motivated3/ESP32-AirSense/doc/enclosure/README.md

# AirDock 60 结构

当前公开方案是 [AirDock 60 分舱底座](airdock-60/README.md)：屏幕与水平面成 60°，水平传感器舱、开放走线、可拆托盘。

公开目录只保留当前模型、工程和生成链所需的 helper / 冻结接口输入。旧 R 编号目录是相对路径依赖，不表示附带整套旧后盖；不必从旧版本开始打印。
