motivated3/ESP32-AirSense/doc/HA端接入与保存说明.md

# HA 端接入与保存说明

方案说明：采用 **1 分钟汇总、正常每分钟上传一次、分钟记录长期保留**，在现有 HA 内看历史。无需 CSV 导出，不用小时／日汇总代替短途行车曲线。

完整契约、配置、位置响应和测试入口见 [HA 集成说明](../homeassistant/README.md)。

## 采集、汇总、上传分别处理

- 固件保持原采集：SCD41 的 CO₂／温湿度约 5 秒新值，SFA40 甲醛约每秒读取。
- 每一分钟累积实际新且有效的样本，保存平均、最高、最低和有效样本数。正常一分钟约 12 组 CO₂／温湿度、60 组甲醛；预热或失败时不足正常，不补零、不凑数。
- 正常每 60 秒上传一条；40 分钟车程约 40 条，长途连续记录。断网后可按原时间补传，唯一键去重，不重复入库。
- 车辆停车断电断网时没有测量。可控关机可尝试补发不足一分钟尾段；突然断电时 RAM 中未上传数据可能丢失。
- AIR V1 固件已实现分钟汇总、独立 HTTPS 上传、失败重试和断网 RAM 补传；按自己的 HA 部署后，仍需检查真实设备上传。

## 复用现有 HTTPS

- 上传：`POST https://ha.example.com:8123/api/air_monitor/ingest`
- 看板：`https://ha.example.com:8123/air-monitor/overview`

上面的地址为占位示例，需替换为自己的 HA HTTPS 地址。自定义集成注册 HA 自身 HTTP 服务，复用现有 HA 的域名、TLS 和端口，不开新公网端口。每设备专属密钥用于自己的记录上传；成功响应还包含 HA 家庭位置，供自动主题使用，不向固件提供 HA 管理令牌。摘要位于 `/config/air_monitor_devices.yaml`，设备端原始密钥放在 Git 忽略的 `.air-ha/credentials.json` 用于本板构建；具体配置见[板型 README](../main/boards/custom/waveshare-air-monitor-1.8-v1/README.md#ha-分钟上报配置)。

## 分钟历史独立长期保存

每条 v2 记录含实际采样开始／结束时间、接收时间、设备 ID、启动会话、序号、开机经过时间及四项分钟统计。SQLite `/config/.storage/air_monitor.sqlite3` 的 `minute_records` 独立表不自动清理；只长期保存分钟汇总，不保存每秒原始值。

HA 原生小时长期统计不能改成一分钟；直接修改 Recorder 历史内部表也不可取。因此用 HA 内的分钟曲线卡片读取独立分钟表，沿用 HA 登录，不增加另一套网站或 App。旧补传以原采样时间出现在该分钟曲线，不逐条重放成当前读数。

当前实体显示最近一段的分钟平均，附最高／最低／样本数。只接受新鲜且更新的当前值，超 120 秒再于 15 秒刷新内变为不可用；通信超时显示离线。停车不永久维持最后读数，不填零；曲线保留缺失标记，空档断线。

未校时两个绝对时间明确为 null，只保留 uptime_ms；记录不能在绝对时间曲线上定位，不能伪造日期。错误／预热／无有效样本的指标用 null。

## 不改变其他 HA 数据

本集成不修改已有 Recorder 的数据库连接、保留天数或过滤配置，也不要求外部 MySQL。Recorder 的清理策略**不影响独立保存的一分钟记录**；部署环境中的设备、自动化及其他数据库策略保持不变。

分钟库需备份及管理磁盘，不能把“不自动清理”当成无需备份。新部署应单独确认备份与恢复，不使用个人开发环境的检查结果作为默认保证。

## HA 内查看

侧栏“空气检测”包含在线状态、最近一分钟平均、四项分钟曲线及最高／最低范围。可选最近一趟、近 7 天／30 天和自选历史时间；单次查询最多 31 天，但保存不设 31 天期限。

“最近一趟”按超过 5 分钟无数据分段、最多显示 24 小时；它不是汽车点火检测。停车和已知无效段断线；短途 40 分钟仍保留约 40 个点。看板不使用按日汇总作主视图。

接口检查字段、单位、数值、时间、批次和大小；事务提交后才 ACK，内容冲突整批回滚；设备收到 accepted 后才释放对应 RAM。细节见协议说明。

参考：[HA Recorder](https://www.home-assistant.io/integrations/recorder/)、[长期统计](https://www.home-assistant.io/docs/configuration/long-term-statistics/)。
