motivated3/ESP32-AirSense/doc/浓度读数颜色分级.md

# 浓度读数颜色分级

保留 368×448 布局，按浓度改变主页及历史页“当前”数字的颜色。温湿度来源保持 SCD41；浓度提醒采用主页状态和可选短提示音，不显示全屏告警弹窗。

## 分级

| 指标 | 原色 | 黄色 | 红色 |
| --- | --- | --- | --- |
| CO₂ / ppm | <1000 | 1000–1999 | ≥2000 |
| 甲醛 / ppb | <65 | 65–79 | ≥80 |

原色沿用原界面的深绿／米白。甲醛以界面显示的四舍五入整数 ppb 分档，使数字和颜色边界一致。浅色背景使用较深的琥珀黄、红色，深绿卡片和夜间采用较亮的同类颜色，保证大数字可读。

颜色是即时浓度提示，独立于用户设置的提醒阈值与连续 30 秒触发规则。关闭提醒或调高提醒值不改变数字分级；持续偏高的状态也不能把高浓度红字覆盖成黄字。当前提醒不显示弹窗，见[行为说明](自动主题与提醒.md)。

## 依据与边界

- 德国环境署 UBA 用 1000 和 2000 ppm 划分 CO₂ 通风提示等级，原文红色范围为 >2000 ppm。本产品把 2000 整值计入红色，属于稍保守的显示边界选择。[UBA 说明](https://www.umweltbundesamt.de/richtig-lueften-in-schulen)、[原始指南](https://www.umweltbundesamt.de/sites/default/files/medien/pdfs/kohlendioxid_2008.pdf)。
- HSE 指出持续高于 1500 ppm 应改善通风，CO₂ 只用于通风参考。因此本次不改变已有默认 1500 ppm 持续 30 秒告警；2000 ppm 不代表急性中毒分界。[HSE 指南](https://www.hse.gov.uk/ventilation/using-co2-monitors.htm)。
- GB/T 18883—2022 的甲醛限值为 0.08 mg/m³、1 小时平均；GB/T 27630—2011 车内指南为 0.10 mg/m³，并有规定的车辆静止、门窗关闭等检测条件。[室内标准](https://www.ndcpa.gov.cn/doc/ucap/1625444428300685312/document/20230607/ZgwODgwF.pdf)、[车内指南](https://sthjt.hubei.gov.cn/hjsj/hbbz/dqhjbhbz/qhjbz/qhjgb/201111/P020111115588026202206.pdf)。
- 以 25°C、101.325 kPa、甲醛摩尔质量约 30.026 g/mol 作理想气体换算，0.08 mg/m³ 约 65.2 ppb，0.10 mg/m³ 约 81.5 ppb。产品使用 65 / 80 ppb 作为方便阅读、稍保守取整的提醒线，不把 0.08 mg/m³ 错当作 80 ppb。

甲醛颜色属于本产品选择的提醒等级，不是标准规定的颜色。实时变色不等于完成标准要求的平均时间、采样和检测流程，不能由此宣称达标或绝对安全。

## 数据状态

无值、未连接、预热、过期、读取错误或额定环境条件不合格时，显示中性色。甲醛负值、非有限值及超出 0–2000 ppb 的无效值不参与分级，显示“—”，不会误变成低浓度原色。CO₂ 高于 5000 ppm 时保留超量程说明，并继续显示红色。

不增加颜色渐变动画或后台刷新任务，复用现有的样本刷新和相同样式去重。不另设大字模式。
