motivated3/ESP32-AirSense/doc/自动主题与提醒.md

# 自动主题与浓度提醒

## 自动主题

设置可选择“日间”“夜间”“自动”。自动模式按太阳位置计算日夜，沿用分别保存的日夜亮度；已有配置不会被强制改成自动。

位置取自自己的 Home Assistant 家庭经纬度，通过已鉴权的分钟上传 ACK 中 `solar_location` 返回。固件校验后缓存到 NVS；UTC 由上传端的 HTTPS Date 建立，不另请求手机定位或第三方定位服务。

**设备上传密钥也能取得 HA 家庭坐标**，因此只应发给可信设备并按私有凭据保存；它不能读取分钟历史或获取 HA 管理权限。旧 HA 集成不返回坐标时固件保持兼容，但首次自动主题需要更新集成、配置位置并完成校时。

同次开机暂时断网后，已缓存位置和已同步的时钟可继续计算。重启后需要重新取得有效 UTC；缺位置或时间时保持当前主题，仍可手动切换。车载设备使用的是 HA 家庭位置，不是车辆实时位置，跨地区行驶时日夜切换可能与当地日出日落不同。

## 浓度提醒

持续偏高通过主页状态与读数颜色表达，保留阈值、各指标和短提示音开关。**不显示全屏告警弹窗，不抢占对话，也不为了告警唤醒屏幕。** 每轮提示音最多一次，遵守音量、静音、音频忙碌及关机保护；忙碌时跳过，不在之后补响。

无效或过期数据不能当作零浓度。颜色阈值的来源、单位和适用范围见[颜色分级](浓度读数颜色分级.md)。
