motivated3/ESP32-AirSense/doc/验证记录.md

# 公开源码快照验证

日期：2026-11-02。本记录只描述本轮源码、无私有 HA 配置的构建和主机验证，不代表新一轮实机刷写或车内测量验收。

| 项目 | 结果 |
| --- | --- |
| ESP-IDF | 固定 `9a97f6c54ec638111ce55cd36581b3c192f15207`，v6.1.0，ESP32-S3 |
| 板型 | `waveshare-air-monitor-1.8-v1`，中文，16 MB Flash / 8 MB PSRAM |
| 专用构建入口 | `bash scripts/build_air_monitor.sh` 完整构建通过 |
| HA 配置 | 构建目录未放 `.air-ha/credentials.json`；生成头为 `kEnabled=false`，地址和密钥均为空 |
| 核心原生测试 | 13 / 13 通过 |
| 含 LVGL 界面的原生测试 | 15 / 15 通过，含主界面和对话页 |
| Python 主机测试 | 运行 296 项，295 项通过、1 项跳过；跳过项为缺少本机 cJSON / mbedTLS 开发头文件的 MCP 测试类 |
| HA 后端 | 29 / 29 通过，真实 SQLite 和回环 HTTP |
| HA 卡片 | 5 / 5 Node 测试通过 |
| AirDock | 导出实体、接口、模块包络、硬件及采样拆卸路径检查通过；3MF 网格、姿态、冻结输入哈希守卫通过 |
| 公开文件检查 | 不含私有配置、旧 Git 历史、设备部署记录、历史 ZIP 和原 `doc/hardware/` 厂商下载；保留的 3MF 内部成员也检查了个人路径及凭据模式 |

主机环境使用 macOS Command Line Tools，C/C++23 编译器明确选择 macOS SDK；为本机直接编译测试临时指定了 SDK 包装器，没有修改项目代码来跳过检查。最初的缺环境依赖/沙盒父进程查询失败在重跑前处理，未计为通过。

当前 README 的三张 PNG 来自本轮原生测试输出，尺寸为 368×448，读数和日期都是测试数据。

## 构建产物校验

以下仅标识本轮本机生成的文件，二进制不纳入 Git，也没有随源码首发上传。

| 文件 | 字节数 | SHA-256 |
| --- | --- | --- |
| `build/xiaozhi.bin` | 3419136 | `43ff2ffad09c14504184b60bfd1621cb82efcbc875eb4a4c0205ed6730be30d8` |
| `build/merged-binary.bin` | 10004645 | `b1b4923cfda5bf4be98e9055c6406f183273e21b99bfc892895ee35c5c65dab5` |
| `build/generated_assets.bin` | 1616037 | `5c4e6eae3478cd58ebfd3596accfca3a8dab1569234a1d08464421f71053f288` |

不同源码、工具环境或构建元数据可能生成不同字节，不能用本表校验之后重新编译的任意固件。刷写地址仍以同次构建的 `flash_args` / `flasher_args.json` 为准。

## 未覆盖的实物验收

本轮没有刷写设备、上传真实浓度到 HA 或启动 3D 打印。传感器真实性与校准、原壳配合、USB 关机电源轨、装壳温升、日晒和车内并发仍需在实际硬件上检查；测试通过不能据此承诺准确室温、固定帧率或阳光下可读性。
