motivated3/ESP32-AirSense/doc/enclosure/airdock-60/AirDock60_roof_vents.png

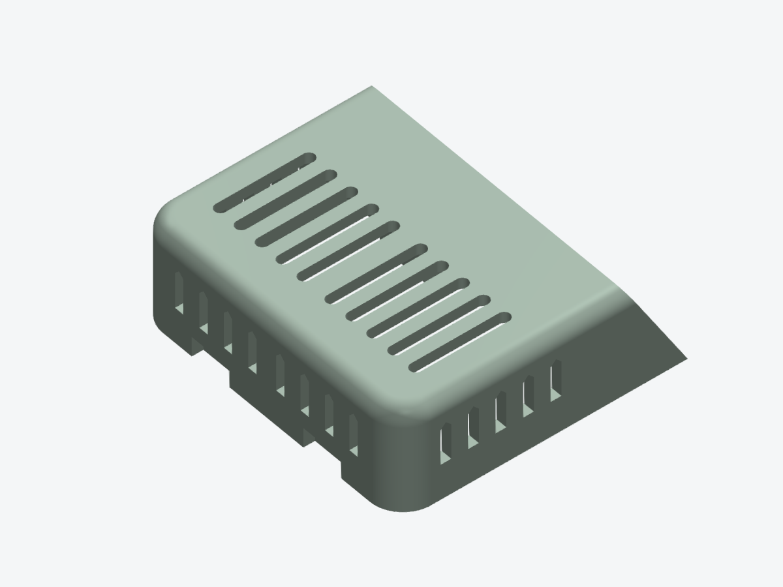
doc/enclosure/airdock-60/AirDock60_roof_vents.png
