motivated3/ESP32-AirSense/doc/enclosure/airdock-60/AirDock60_TRAY.step

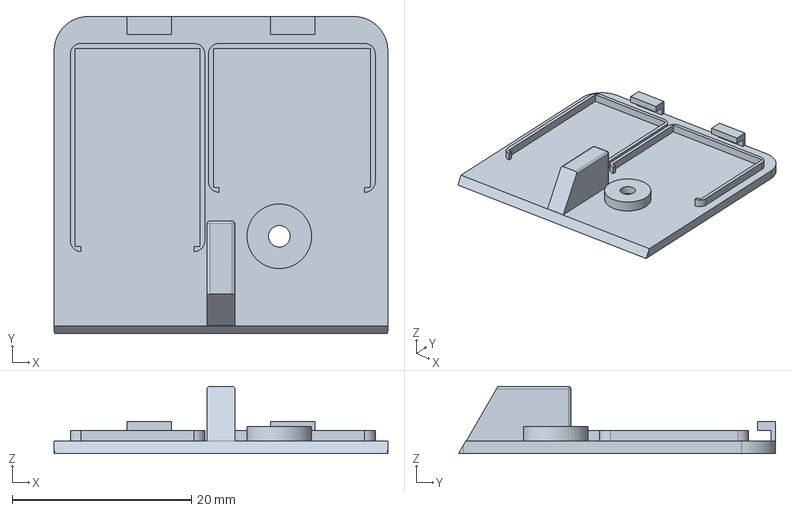
[picture p9: CAD file, 2026-11-02]
doc/enclosure/airdock-60/AirDock60_TRAY.step
37.2 x 35.3 x 7.50 mm
