motivated3/ESP32-AirSense/doc/enclosure/r12-continuous-round/support-interface/R12_PETG_LOCAL_SUPPORT_INTERFACE_BambuStudio.3mf

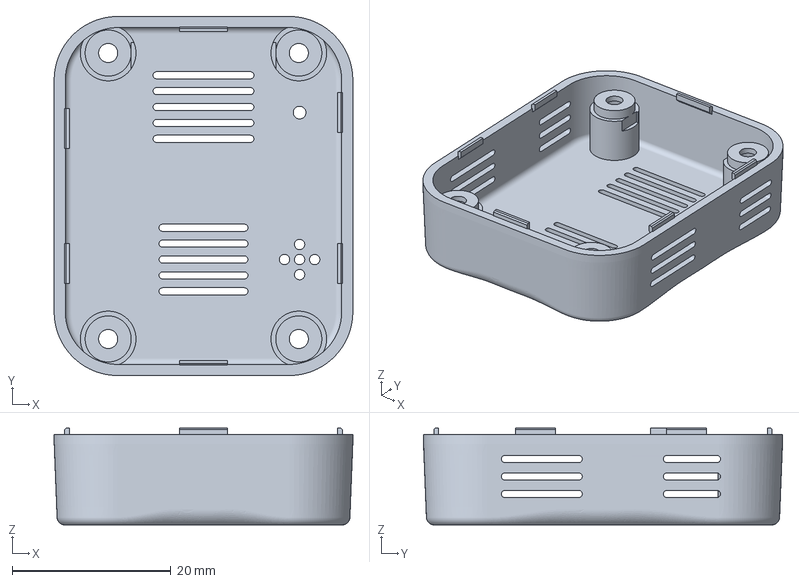
[picture p10: CAD file, 2026-11-02]
doc/enclosure/r12-continuous-round/support-interface/R12_PETG_LOCAL_SUPPORT_INTERFACE_BambuStudio.3mf
37.6 x 45.2 x 12.2 mm
