motivated3/ESP32-AirSense/doc/enclosure/r8-wide-base/R8_BASE.step

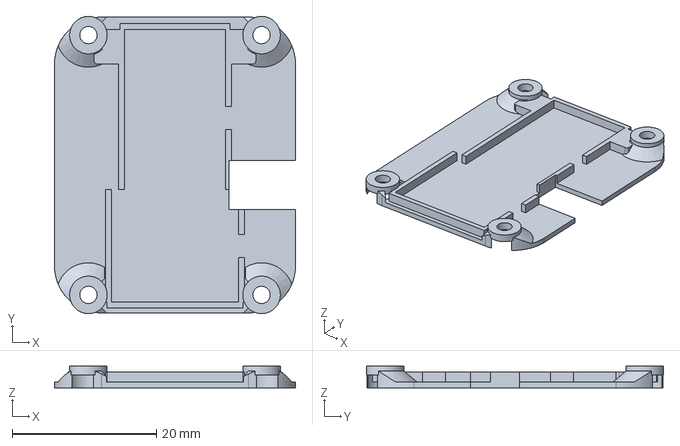
[picture p11: CAD file, 2026-11-02]
doc/enclosure/r8-wide-base/R8_BASE.step
33.4 x 41.2 x 3.00 mm
