motivated3/ESP32-AirSense/doc/enclosure/airdock-60/AirDock60_MOUNT.step

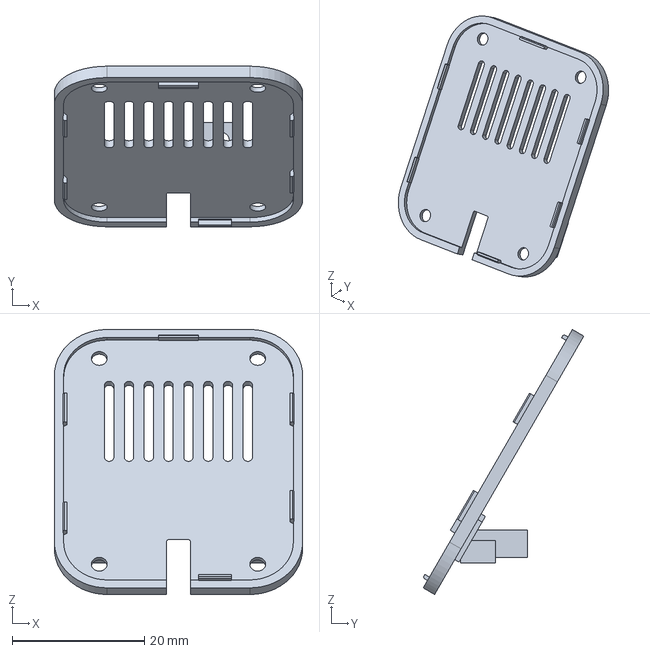
[picture p12: CAD file, 2026-11-02]
doc/enclosure/airdock-60/AirDock60_MOUNT.step
37.6 x 24.3 x 40.1 mm
