motivated3/ESP32-AirSense/doc/enclosure/airdock-60/AirDock60_GEOMETRY_BambuStudio.3mf

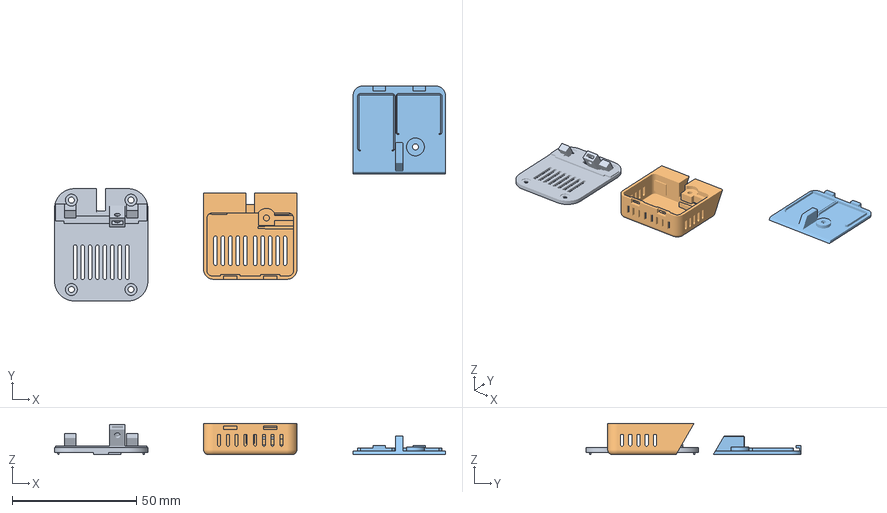
[picture p13: CAD file, 2026-11-02]
doc/enclosure/airdock-60/AirDock60_GEOMETRY_BambuStudio.3mf
157.4 x 86.5 x 12.6 mm
AirDock60_MOUNT
AirDock60_BAY
AirDock60_TRAY
