motivated3/ESP32-AirSense/doc/enclosure/airdock-60/AirDock60_BAY.step

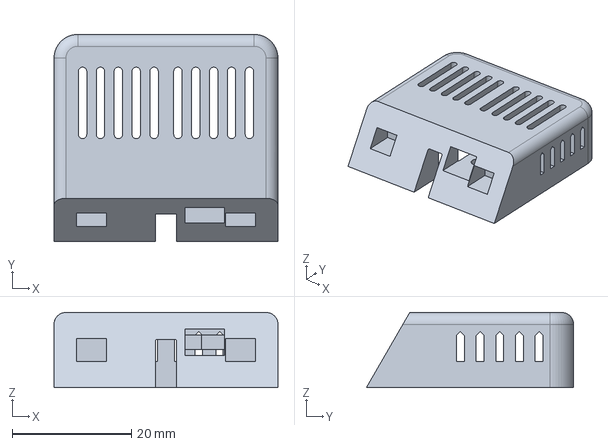
[picture p14: CAD file, 2026-11-02]
doc/enclosure/airdock-60/AirDock60_BAY.step
37.6 x 34.8 x 12.6 mm
