motivated3/ESP32-AirSense/(list of files, cad)

Other CAD files:
doc/enclosure/airdock-60/AirDock60_BambuStudio.3mf
doc/enclosure/airdock-60/AirDock60_BAY.stl
doc/enclosure/airdock-60/AirDock60_MOUNT.stl
doc/enclosure/airdock-60/AirDock60_TRAY.stl
doc/enclosure/r8-wide-base/R8_BASE.stl
