motivated3/ESP32-AirSense/main/application.h

#ifndef _APPLICATION_H_
#define _APPLICATION_H_

#include <freertos/FreeRTOS.h>
#include <freertos/event_groups.h>
#include <freertos/task.h>
#include <esp_timer.h>

#include <atomic>
#include <cstdint>
#include <deque>
#include <functional>
#include <memory>
#include <mutex>
#include <string>
#include <vector>

#include "protocol.h"
#include "ota.h"
#include "audio_service.h"
#include "device_state.h"
#include "device_state_machine.h"
#include "notify/notify_player.h"

// Main event bits
#define MAIN_EVENT_SCHEDULE             (1 << 0)
#define MAIN_EVENT_SEND_AUDIO           (1 << 1)
#define MAIN_EVENT_WAKE_WORD_DETECTED   (1 << 2)
#define MAIN_EVENT_VAD_CHANGE           (1 << 3)
#define MAIN_EVENT_ERROR                (1 << 4)
#define MAIN_EVENT_ACTIVATION_DONE      (1 << 5)
#define MAIN_EVENT_CLOCK_TICK           (1 << 6)
#define MAIN_EVENT_NETWORK_CONNECTED    (1 << 7)
#define MAIN_EVENT_NETWORK_DISCONNECTED (1 << 8)
#define MAIN_EVENT_TOGGLE_CHAT          (1 << 9)
#define MAIN_EVENT_START_LISTENING      (1 << 10)
#define MAIN_EVENT_STOP_LISTENING       (1 << 11)
#define MAIN_EVENT_STATE_CHANGED        (1 << 12)
#define MAIN_EVENT_PLAYBACK_DRAINED     (1 << 13)
#define MAIN_EVENT_STARTUP_HINT_TIMEOUT (1 << 14)

enum AecMode {
    kAecOff,
    kAecOnDeviceSide,
    kAecOnServerSide,
};

class Application {
public:
    static Application& GetInstance() {
        static Application instance;
        return instance;
    }
    // Delete copy constructor and assignment operator
    Application(const Application&) = delete;
    Application& operator=(const Application&) = delete;

    /**
     * Initialize the application
     * This sets up display, audio, network callbacks, etc.
     * Network connection starts asynchronously.
     */
    void Initialize();

    /**
     * Run the main event loop
     * This function runs in the main task and never returns.
     * It handles all events including network, state changes, and user interactions.
     */
    void Run();

    DeviceState GetDeviceState() const { return state_machine_.GetState(); }
    bool IsVoiceDetected() const { return audio_service_.IsVoiceDetected(); }
    
    /**
     * Request state transition
     * Returns true if transition was successful
     */
    bool SetDeviceState(DeviceState state);

    /**
     * Schedule a callback to be executed in the main task
     */
    void Schedule(std::function<void()>&& callback);

    /**
     * Alert with status, message, emotion and optional sound
     */
    void Alert(const char* status, const char* message, const char* emotion = "", const std::string_view& sound = "");
    void DismissAlert();

    void AbortSpeaking(AbortReason reason);

    /**
     * Toggle chat state (event-based, thread-safe)
     * Sends MAIN_EVENT_TOGGLE_CHAT to be handled in Run()
     */
    void ToggleChatState();

    /**
     * Start listening (event-based, thread-safe)
     * Sends MAIN_EVENT_START_LISTENING to be handled in Run()
     */
    void StartListening();

    /**
     * Stop listening (event-based, thread-safe)
     * Sends MAIN_EVENT_STOP_LISTENING to be handled in Run()
     */
    void StopListening();

    // End the current conversation on the main task while preserving voice and wake settings.
    void EndVoiceSession();

    void Reboot();
    // Called on the application task; power coordination itself stays in the board task.
    void PrepareForShutdown();
    bool IsShutdownReady() const {
        return shutting_down_.load() && !activation_running_.load() && audio_service_.IsStopped();
    }
    void SetVoiceEnabled(bool enabled);
    void WakeWordInvoke(const std::string& wake_word);
    bool UpgradeFirmware(const std::string& url, const std::string& version = "");
    bool CanEnterSleepMode();
    void SendMcpMessage(const std::string& payload);
    void RegisterMcpBroadcastCallback(std::function<void(const std::string&)> callback);
    void SetAecMode(AecMode mode);
    AecMode GetAecMode() const { return aec_mode_; }
    void PlaySound(const std::string_view& sound);
    AudioService& GetAudioService() { return audio_service_; }
    
    /**
     * Reset protocol resources (thread-safe)
     * Can be called from any task to release resources allocated after network connected
     * This includes closing audio channel, resetting protocol and ota objects
     */
    void ResetProtocol();

private:
    Application();
    ~Application();

    std::mutex mutex_;
    std::deque<std::function<void()>> main_tasks_;
    std::unique_ptr<Protocol> protocol_;
    EventGroupHandle_t event_group_ = nullptr;
    esp_timer_handle_t clock_timer_handle_ = nullptr;
    esp_timer_handle_t startup_wake_word_hint_timer_ = nullptr;
    DeviceStateMachine state_machine_;
    ListeningMode listening_mode_ = kListeningModeAutoStop;
    AecMode aec_mode_ = kAecOff;
    std::string last_error_message_;
    std::string startup_wake_word_hint_message_;
    AudioService audio_service_;
    NotifyPlayer notify_player_;
    uint32_t notification_playback_id_ = 0;
    std::unique_ptr<Ota> ota_;

    std::function<void(const std::string&)> mcp_broadcast_callback_;

    bool has_server_time_ = false;
    bool startup_completed_ = false;
    bool pending_startup_wake_word_hint_ = false;
    bool aborted_ = false;
    bool voice_session_cancelled_ = false;  // Main-task guard for callbacks after a user stop.
    std::atomic<uint32_t> voice_session_generation_{0};
    bool assets_version_checked_ = false;
    bool play_popup_on_listening_ = false;  // Flag to play popup sound after state changes to listening
    bool pending_listening_start_ = false;  // Waiting for playback to drain before starting listening (auto mode)
    int clock_ticks_ = 0;
    TaskHandle_t activation_task_handle_ = nullptr;
    std::atomic<bool> shutting_down_{false}, activation_running_{false};

    // Event handlers
    void HandleStateChangedEvent();
    void HandleToggleChatEvent();
    void HandleStartListeningEvent();
    void HandleStopListeningEvent();
    void HandleNetworkConnectedEvent();
    void HandleNetworkDisconnectedEvent();
    void HandleActivationDoneEvent();
    void HandleWakeWordDetectedEvent();
    void ContinueOpenAudioChannel(ListeningMode mode);
    void BeginWakeWordInvoke(const std::string& wake_word);
    void ContinueWakeWordInvoke(const std::string& wake_word);
    void StartListeningAudio();
    void ConfigureWakeWordForListening();
    void ShowStartupWakeWordHint();
    void HideStartupWakeWordHint();
    void StartNotification(std::string audio_url, std::vector<NotifySubtitle> subtitles);
    void StopNotification();
    void HandleNotificationFinished(uint32_t playback_id, bool success);

    // Activation task (runs in background)
    void ActivationTask();

    // Helper methods
    void CheckAssetsVersion();
    void CheckNewVersion();
    void InitializeProtocol();
    void ShowActivationCode(const std::string& code, const std::string& message);
    void SetListeningMode(ListeningMode mode);
    ListeningMode GetDefaultListeningMode() const;
    
    // State change handler called by state machine
    void OnStateChanged(DeviceState old_state, DeviceState new_state);
};


class TaskPriorityReset {
public:
    TaskPriorityReset(BaseType_t priority) {
        original_priority_ = uxTaskPriorityGet(NULL);
        vTaskPrioritySet(NULL, priority);
    }
    ~TaskPriorityReset() {
        vTaskPrioritySet(NULL, original_priority_);
    }

private:
    BaseType_t original_priority_;
};

#endif // _APPLICATION_H_
