motivated3/ESP32-AirSense/main/boards/custom/waveshare-air-monitor-1.8-v1/sensirion_protocol.h

#pragma once
#include "air_types.h"
namespace air {
uint8_t Crc8(const uint8_t* bytes, size_t length);
bool DecodeScd41(const uint8_t* bytes, size_t length, Scd41Reading& result);
bool DecodeSfa40(const uint8_t* bytes, size_t length, Sfa40Reading& result);
bool DecodeScd41Ready(const uint8_t* bytes, size_t length, bool& result);
bool DecodeWord(const uint8_t* bytes, size_t length, uint16_t& result);
}  // namespace air
